nikolaus018/garageDoor-pro/hardware/production/render-bottom.png

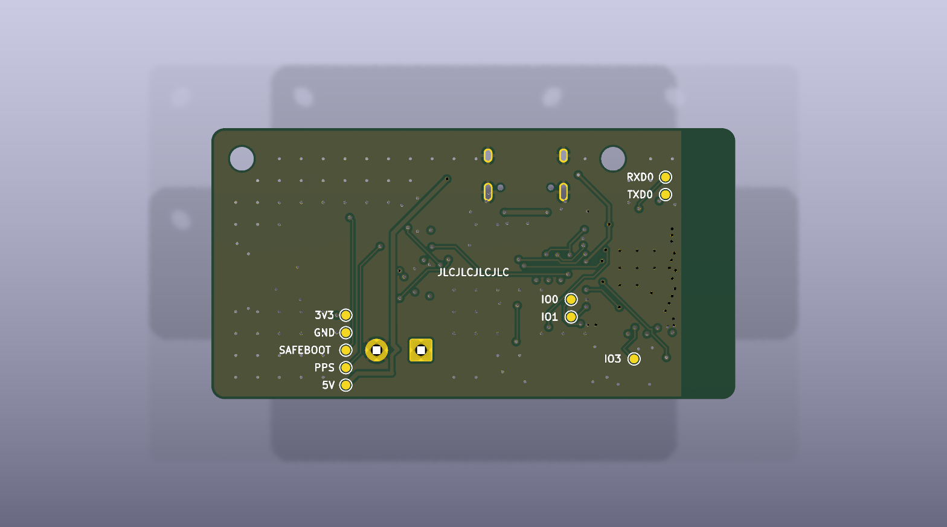
hardware/production/render-bottom.png
