nikolaus018/garageDoor-pro/hardware/production/render-top.png

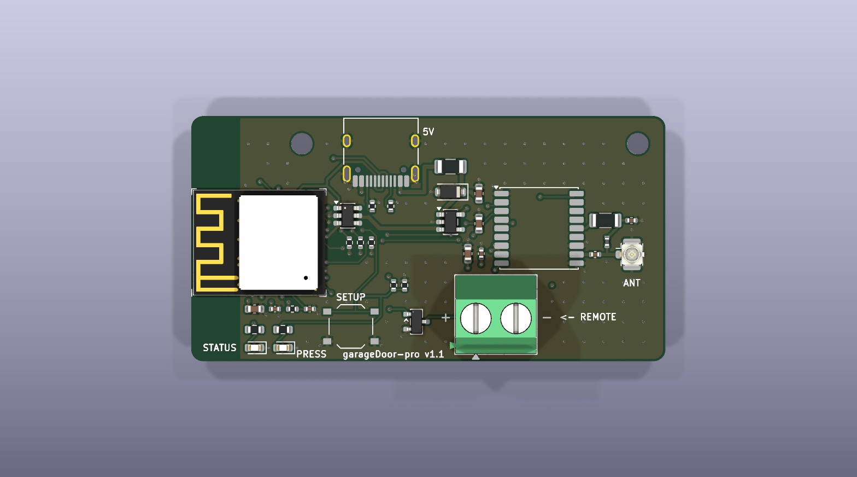
hardware/production/render-top.png
