nikolaus018/garageDoor-pro/hardware/production/bom-jlcpcb.csv

Comment | Designator | Footprint | LCSC Part # | Manufacturer Part | Quantity
10nF | C1 | C_0402_1005Metric | C15195 | CL05B103KB5NNNC | 1
47pF C0G | C2 | C_0402_1005Metric | C1567 | 0402CG470J500NT | 1
10uF | C3,C4,C5,C7 | C_0603_1608Metric | C19702 | CL10A106KP8NNNC | 4
100nF | C6,C8 | C_0402_1005Metric | C60474 | CC0402KRX7R7BB104 | 2
1uF | C9 | C_0402_1005Metric | C14445 | CL05A105KP5NNNC | 1
SMF5.0A | D1 | D_SOD-123F | C1509112 | SMF5.0A | 1
RED | D2 | LED_0603_1608Metric | C2286 | KT-0603R | 1
GREEN | D3 | LED_0603_1608Metric | C12624 | KT-0603G | 1
500mA | F1 | Fuse_1206_3216Metric | C22472478 | SMD1206-050C-6V | 1
USB-C | J1 | USB_C_Receptacle_HRO_TYPE-C-31-M-12 | C165948 | TYPE-C-31-M-12 | 1
U.FL GNSS antenna | J2 | U.FL_Hirose_U.FL-R-SMT-1_Vertical | C88373 | U.FL-R-SMT-1(10) | 1
Remote button | J3 | TerminalBlock_Phoenix_MKDS-1,5-2-5.08_1x02_P5.08mm_Horizontal | C474952 | KF128-5.08-2P | 1
27nH | L1 | L_0402_1005Metric | C12669 | LQG15HS27NJ02D | 1
SS8050 | Q1 | SOT-23 | C2150 | SS8050 | 1
10R | R1 | R_1206_3216Metric | C17903 | 1206W4F100JT5E | 1
10k | R2,R3,R4,R5 | R_0402_1005Metric | C25744 | 0402WGF1002TCE | 4
5.1k | R6,R7 | R_0402_1005Metric | C25905 | 0402WGF5101TCE | 2
330R | R8 | R_0402_1005Metric | C25104 | 0402WGF3300TCE | 1
100k | R9 | R_0402_1005Metric | C25741 | 0402WGF1003TCE | 1
1k | R10,R11 | R_0603_1608Metric | C21190 | 0603WAF1001T5E | 2
SETUP | SW1 | SW_Push_1P1T_XKB_TS-1187A | C318884 | TS-1187A-B-A-B | 1
ESP32-C3-MINI-1-H4X | U1 | ESP32-C3-MINI-1 | C41349510 | ESP32-C3-MINI-1-H4X | 1
MAX-M10S | U2 | ublox_MAX | C4153167 | MAX-M10S-00B | 1
AP2112K-3.3 | U3 | SOT-23-5 | C51118 | AP2112K-3.3TRG1 | 1
USBLC6-2SC6 | U4 | SOT-23-6 | C7519 | USBLC6-2SC6 | 1
