nikolaus018/garageDoor-pro/prototype/case/garageDoor-case.3mf

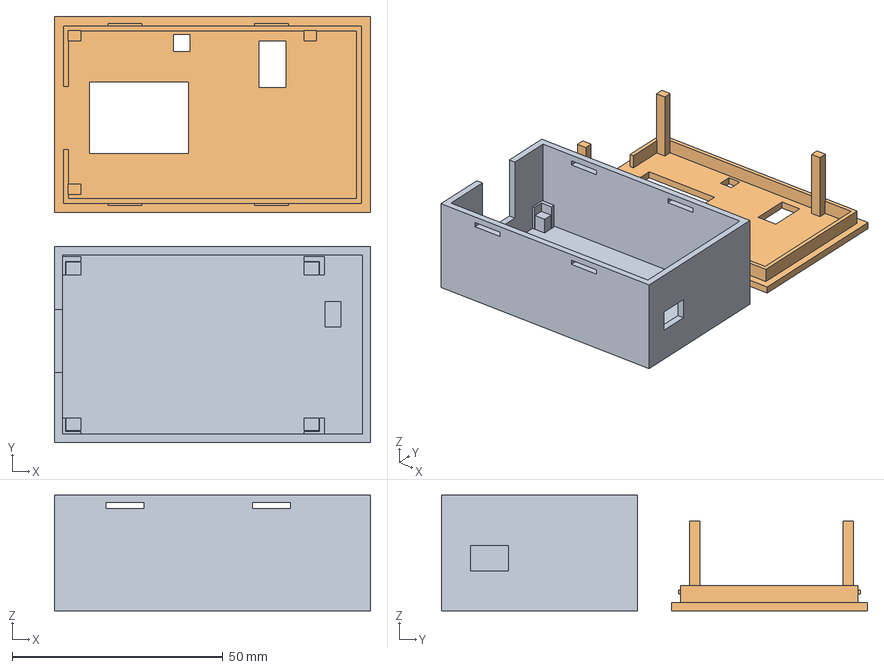
[picture p6: CAD file, 2026-10-16]
prototype/case/garageDoor-case.3mf
75.1 x 101.1 x 27.5 mm
tray
lid
