nikolaus018/garageDoor-pro/hardware/production/schematic.pdf

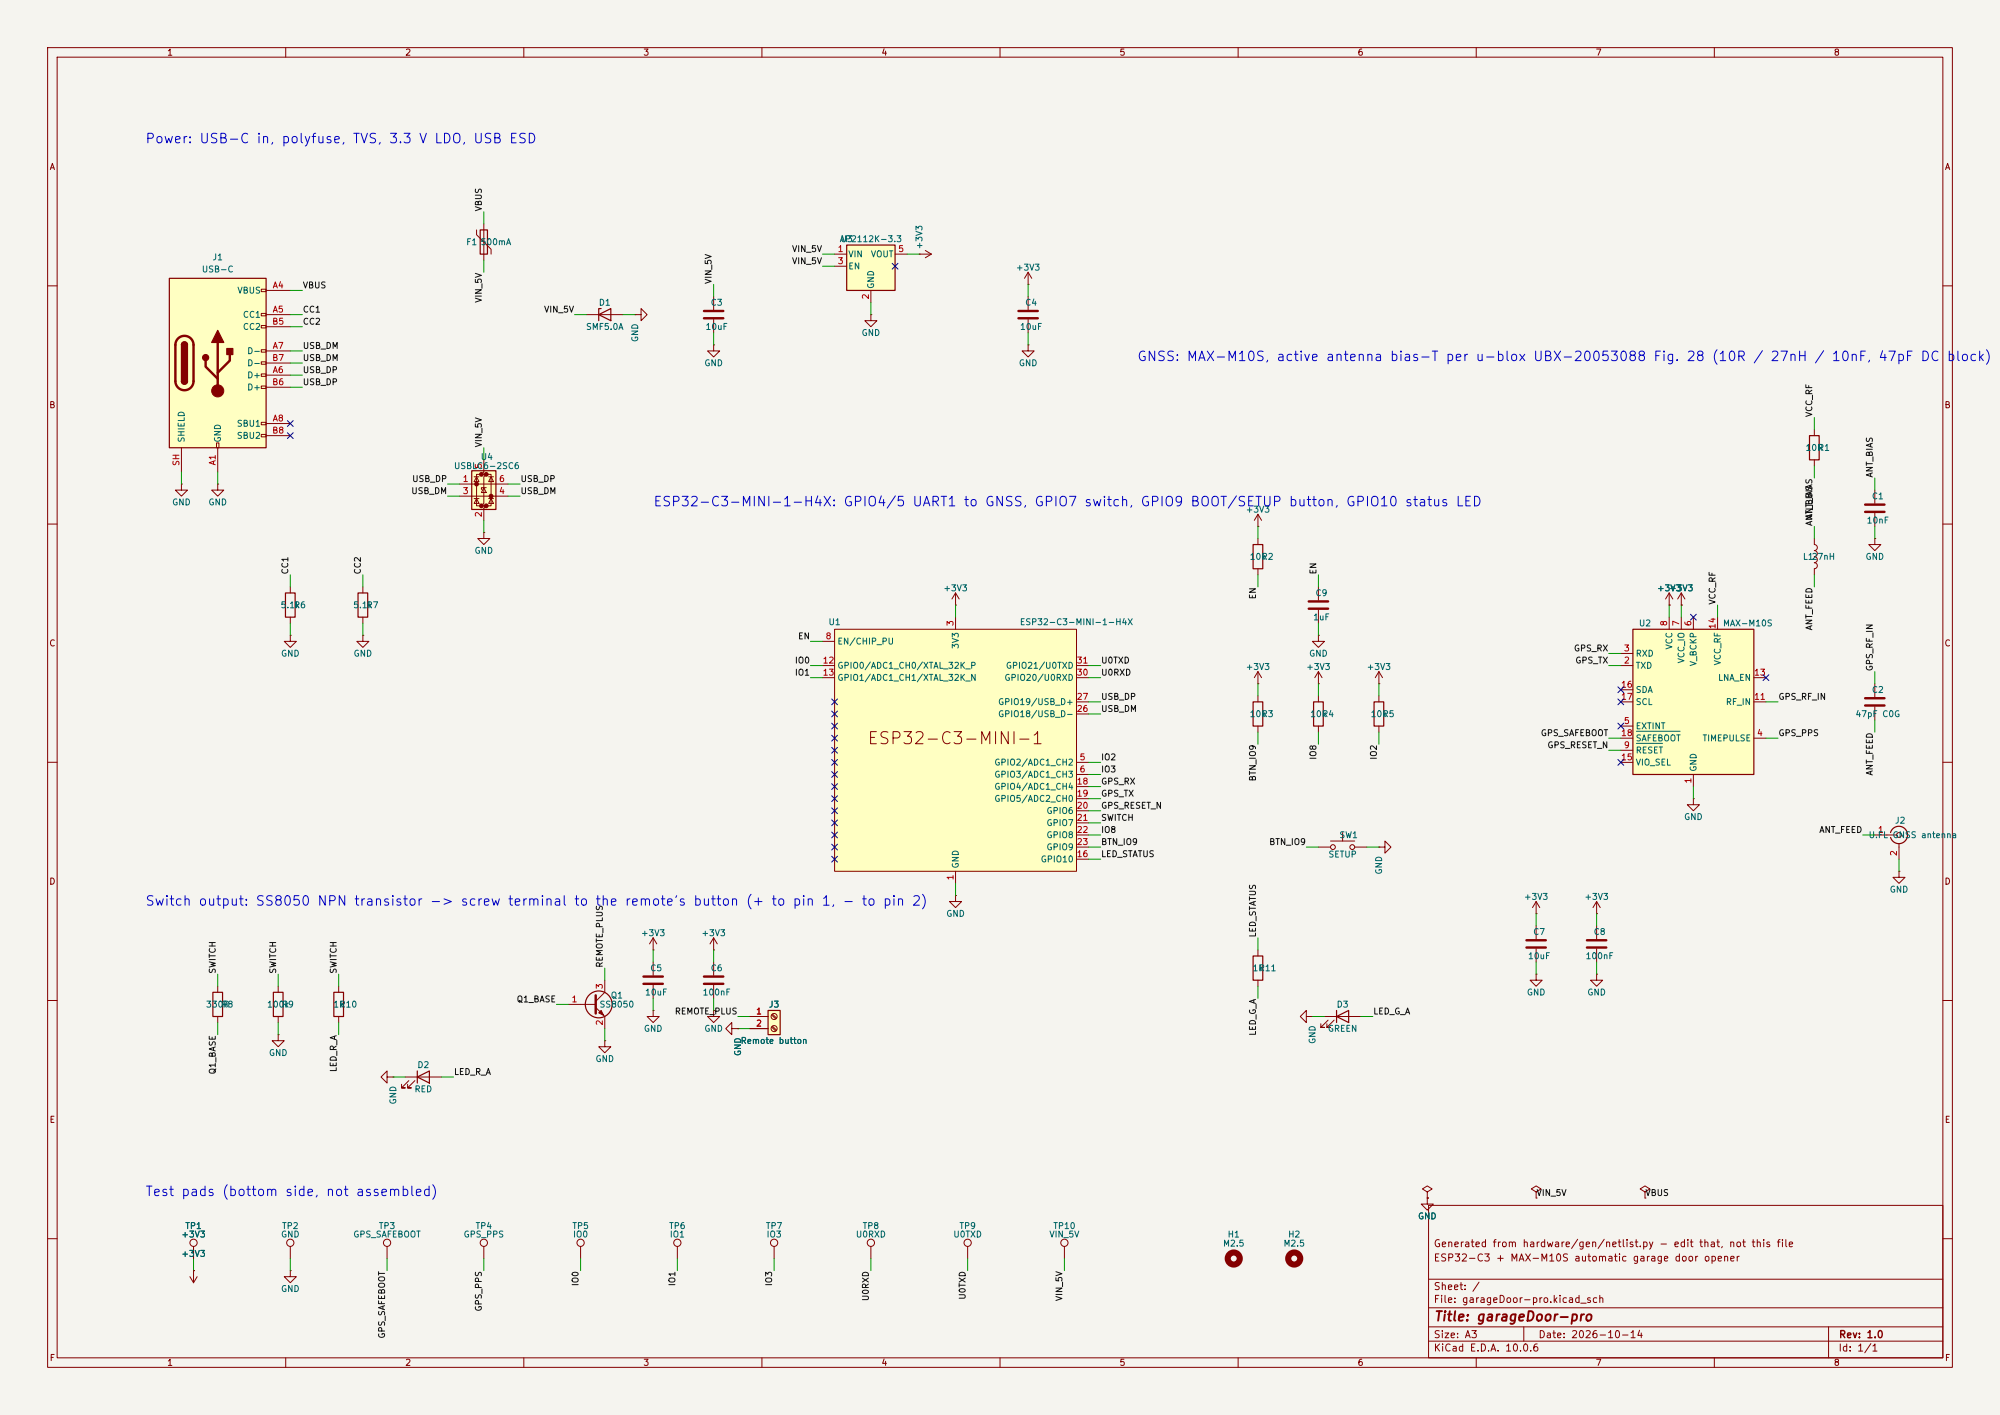
[picture p7: page 1]

IO1 Power: USB-C in, polyfuse, TVS, 3.3 V LDO, USB ESD

GNSS: MAX-M10S, active antenna bias-T per u-blox UBX-20053088 Fig. 28 (10R / 27nH / 10nF, 47pF DC block)

ESP32-C3-MINI-1-H4X: GPIO4/5 UART1 to GNSS, GPIO7 switch, GPIO9 BOOT/SETUP button, GPIO10 status LED

Generated from hardware/gen/netlist.py - edit that, not this file +3V3 GND

Test pads (bottom side, not assembled)

ESP32-C3 + MAX-M10S automatic garage door opener

Size: A3 | Rev: 1.0 | F Date: 2026-10-14
KiCad E.D.A. 10.0.6 | Id: 1/1
