nikolaus018/garageDoor-pro/hardware/production/assembly-top.pdf

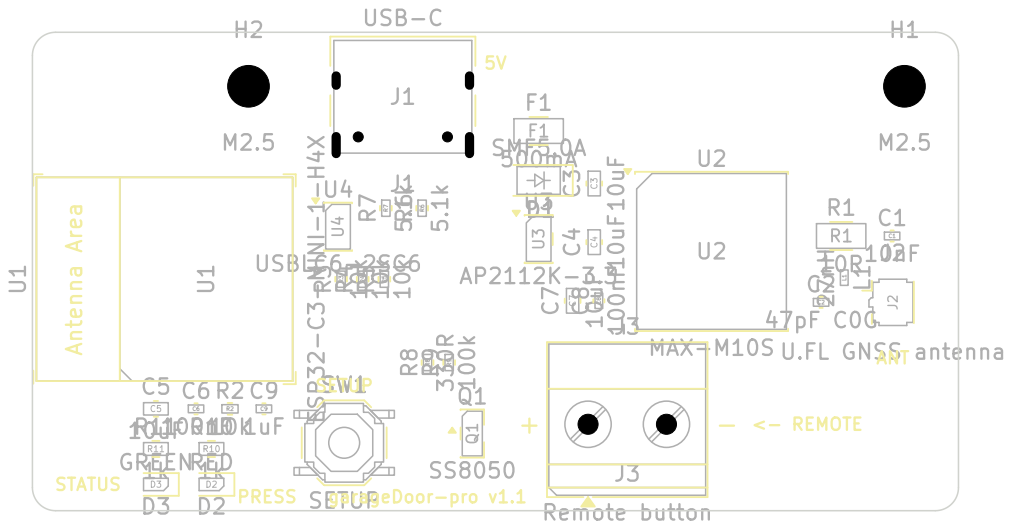
[picture p8: page 1]
