nikolaus018/garageDoor-pro/hardware/garageDoor-pro.kicad_pcb

## KiCad design hardware/garageDoor-pro.kicad_pcb (2026-10-15)

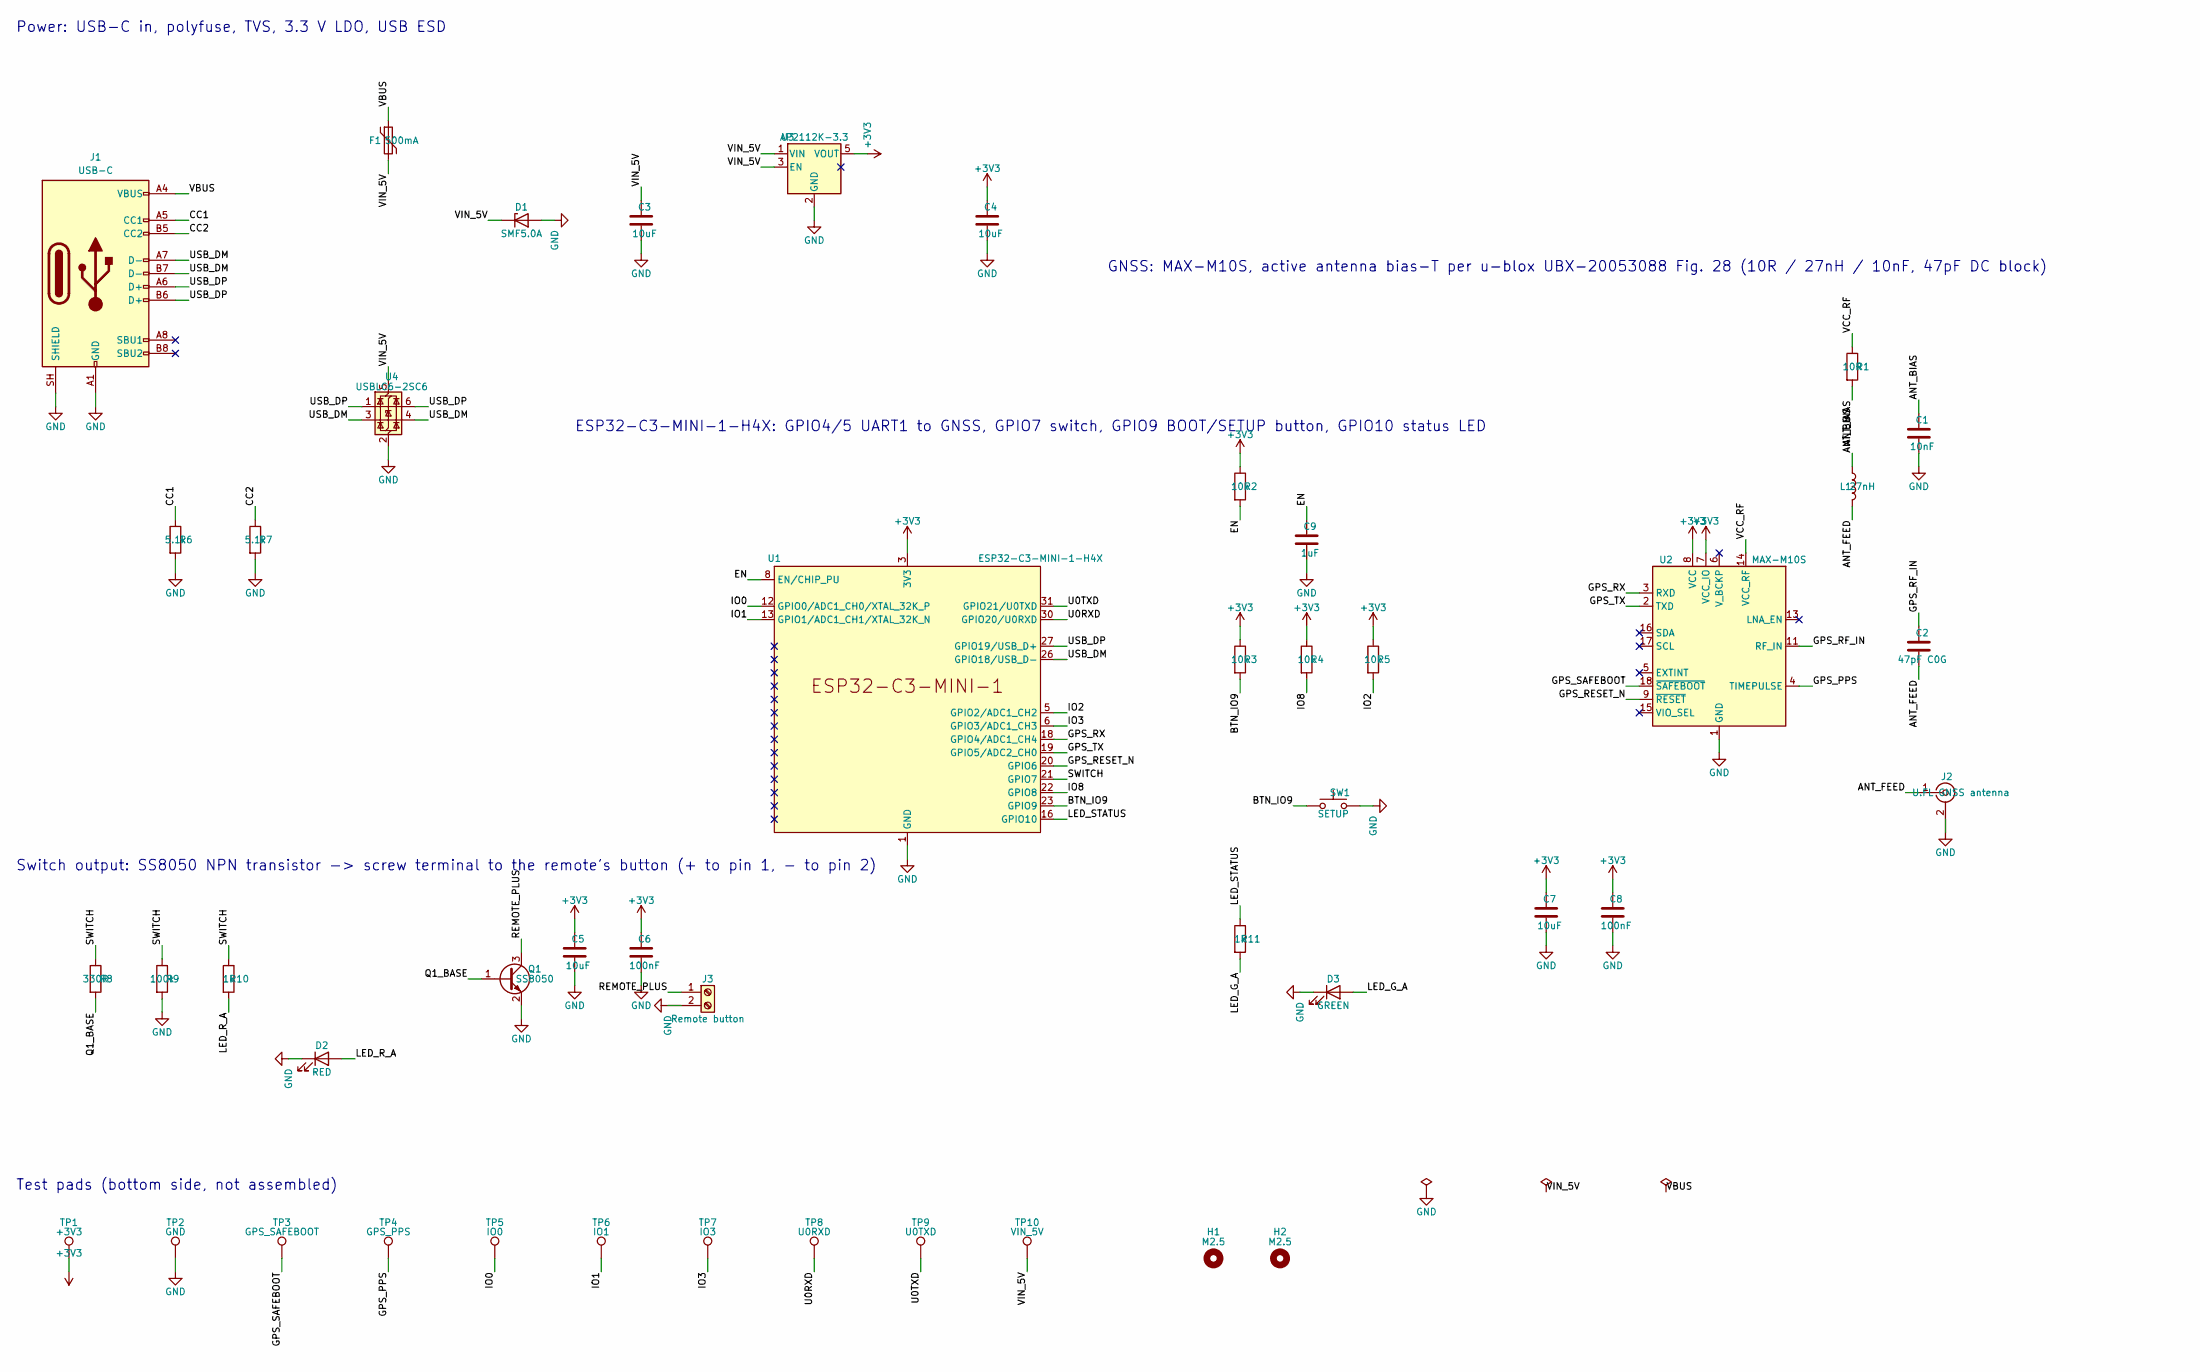
[picture p9: schematic garageDoor-pro.kicad_sch]

Parts:
C1: 10nF; C_0402_1005Metric; MPN CL05B103KB5NNNC; LCSC C15195
C2: 47pF C0G; C_0402_1005Metric; MPN 0402CG470J500NT; LCSC C1567
C3, C4, C5, C7: 10uF; C_0603_1608Metric; MPN CL10A106KP8NNNC; LCSC C19702
C6, C8: 100nF; C_0402_1005Metric; MPN CC0402KRX7R7BB104; LCSC C60474
C9: 1uF; C_0402_1005Metric; MPN CL05A105KP5NNNC; LCSC C14445
D1: SMF5.0A; D_SOD-123F; MPN SMF5.0A; LCSC C1509112
D2: RED; LED_0603_1608Metric; MPN KT-0603R; LCSC C2286
D3: GREEN; LED_0603_1608Metric; MPN KT-0603G; LCSC C12624
F1: 500mA; Fuse_1206_3216Metric; MPN SMD1206-050C-6V; LCSC C22472478
H1, H2: M2.5; MountingHole_2.7mm_M2.5
J1: USB-C; USB_C_Receptacle_HRO_TYPE-C-31-M-12; MPN TYPE-C-31-M-12; LCSC C165948
J2: U.FL GNSS antenna; U.FL_Hirose_U.FL-R-SMT-1_Vertical; MPN U.FL-R-SMT-1(10); LCSC C88373
J3: Remote button; TerminalBlock_Phoenix_MKDS-1,5-2-5.08_1x02_P5.08mm_Horizont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; MPN KF128-5.08-2P; LCSC C474952
L1: 27nH; L_0402_1005Metric; MPN LQG15HS27NJ02D; LCSC C12669
Q1: SS8050; SOT-23; MPN SS8050; LCSC C2150
R1: 10R; R_1206_3216Metric; MPN 1206W4F100JT5E; LCSC C17903
R2, R3, R4, R5: 10k; R_0402_1005Metric; MPN 0402WGF1002TCE; LCSC C25744
R6, R7: 5.1k; R_0402_1005Metric; MPN 0402WGF5101TCE; LCSC C25905
R8: 330R; R_0402_1005Metric; MPN 0402WGF3300TCE; LCSC C25104
R9: 100k; R_0402_1005Metric; MPN 0402WGF1003TCE; LCSC C25741
R10, R11: 1k; R_0603_1608Metric; MPN 0603WAF1001T5E; LCSC C21190
SW1: SETUP; SW_Push_1P1T_XKB_TS-1187A; MPN TS-1187A-B-A-B; LCSC C318884
TP1: +3V3; TestPoint_Pad_D1.0mm
TP2: GND; TestPoint_Pad_D1.0mm
TP3: GPS_SAFEBOOT; TestPoint_Pad_D1.0mm
TP4: GPS_PPS; TestPoint_Pad_D1.0mm
TP5: IO0; TestPoint_Pad_D1.0mm
TP6: IO1; TestPoint_Pad_D1.0mm
TP7: IO3; TestPoint_Pad_D1.0mm
TP8: U0RXD; TestPoint_Pad_D1.0mm
TP9: U0TXD; TestPoint_Pad_D1.0mm
TP10: VIN_5V; TestPoint_Pad_D1.0mm
U1: ESP32-C3-MINI-1-H4X; ESP32-C3-MINI-1; MPN ESP32-C3-MINI-1-H4X; LCSC C41349510
U2: MAX-M10S; ublox_MAX; MPN MAX-M10S-00B; LCSC C4153167
U3: AP2112K-3.3; SOT-23-5; MPN AP2112K-3.3TRG1; LCSC C51118
U4: USBLC6-2SC6; SOT-23-6; MPN USBLC6-2SC6; LCSC C7519

Connections:
+3V3: C4.1, C5.1, C6.1, C7.1, C8.1, R2.1, R3.1, R4.1, R5.1, TP1.1, U1.3 (3V3), U2.7 (VCC_IO), U2.8 (VCC), U3.5 (VOUT)
/ANT_BIAS: C1.1, L1.1, R1.2
/ANT_FEED: C2.2, J2.1 (In), L1.2
/BTN_IO9: R3.2, SW1.1, U1.23 (GPIO9)
/CC1: J1.A5 (CC1), R6.1
/CC2: J1.B5 (CC2), R7.1
/EN: C9.1, R2.2, U1.8 (EN/CHIP_PU)
/GPS_PPS: TP4.1, U2.4 (TIMEPULSE)
/GPS_RESET_N: U1.20 (GPIO6), U2.9 (~RESET)
/GPS_RF_IN: C2.1, U2.11 (RF_IN)
/GPS_RX: U1.18 (GPIO4/ADC1_CH4), U2.3 (RXD)
/GPS_SAFEBOOT: TP3.1, U2.18 (~SAFEBOOT)
/GPS_TX: U1.19 (GPIO5/ADC2_CH0), U2.2 (TXD)
/IO0: TP5.1, U1.12 (GPIO0/ADC1_CH0/XTAL_32K_P)
/IO1: TP6.1, U1.13 (GPIO1/ADC1_CH1/XTAL_32K_N)
/IO2: R5.2, U1.5 (GPIO2/ADC1_CH2)
/IO3: TP7.1, U1.6 (GPIO3/ADC1_CH3)
/IO8: R4.2, U1.22 (GPIO8)
/LED_G_A: D3.2 (A), R11.2
/LED_R_A: D2.2 (A), R10.2
/LED_STATUS: R11.1, U1.16 (GPIO10)
/Q1_BASE: Q1.1 (B), R8.2
/REMOTE_PLUS: J3.1, Q1.3 (C)
/SWITCH: R8.1, R9.1, R10.1, U1.21 (GPIO7)
/U0RXD: TP8.1, U1.30 (GPIO20/U0RXD)
/U0TXD: TP9.1, U1.31 (GPIO21/U0TXD)
/USB_DM: J1.A7 (D-), J1.B7 (D-), U1.26 (GPIO18/USB_D-), U4.3 (I/O2), U4.4 (I/O2)
/USB_DP: J1.A6 (D+), J1.B6 (D+), U1.27 (GPIO19/USB_D+), U4.1 (I/O1), U4.6 (I/O1)
/VBUS: F1.1, J1.A4 (VBUS), J1.A9 (VBUS), J1.B4 (VBUS), J1.B9 (VBUS)
/VCC_RF: R1.1, U2.14 (VCC_RF)
/VIN_5V: C3.1, D1.1 (K), F1.2, TP10.1, U3.1 (VIN), U3.3 (EN), U4.5 (VBUS)
GND: C1.2, C3.2, C4.2, C5.2, C6.2, C7.2, C8.2, C9.2, D1.2 (A), D2.1 (K), D3.1 (K), J1.A1 (GND), J1.A12 (GND), J1.B1 (GND), J1.B12 (GND), J1.SH (SHIELD), J2.2 (Ext), J3.2, Q1.2 (E), R6.2, R7.2, R9.2, SW1.2, TP2.1, U1.1 (GND), U1.2 (GND), U1.11 (GND), U1.14 (GND), U1.36 (GND), U1.37 (GND), U1.38 (GND), U1.39 (GND), U1.40 (GND), U1.41 (GND), U1.42 (GND), U1.43 (GND), U1.44 (GND), U1.45 (GND), U1.46 (GND), U1.47 (GND), U1.48 (GND), U1.49 (GND), U1.50 (GND), U1.51 (GND), U1.52 (GND), U1.53 (GND), U2.1 (GND), U2.10 (GND), U2.12 (GND), U3.2 (GND), U4.2 (GND)

Notes on the sheet:
Power: USB-C in, polyfuse, TVS, 3.3 V LDO, USB ESD
ESP32-C3-MINI-1-H4X: GPIO4/5 UART1 to GNSS, GPIO7 switch, GPIO9 BOOT/SETUP button, GPIO10 status LED
GNSS: MAX-M10S, active antenna bias-T per u-blox UBX-20053088 Fig. 28 (10R / 27nH / 10nF, 47pF DC block)
Switch output: SS8050 NPN transistor -> screw terminal to the remote's button (+ to pin 1, - to pin 2)
Test pads (bottom side, not assembled)

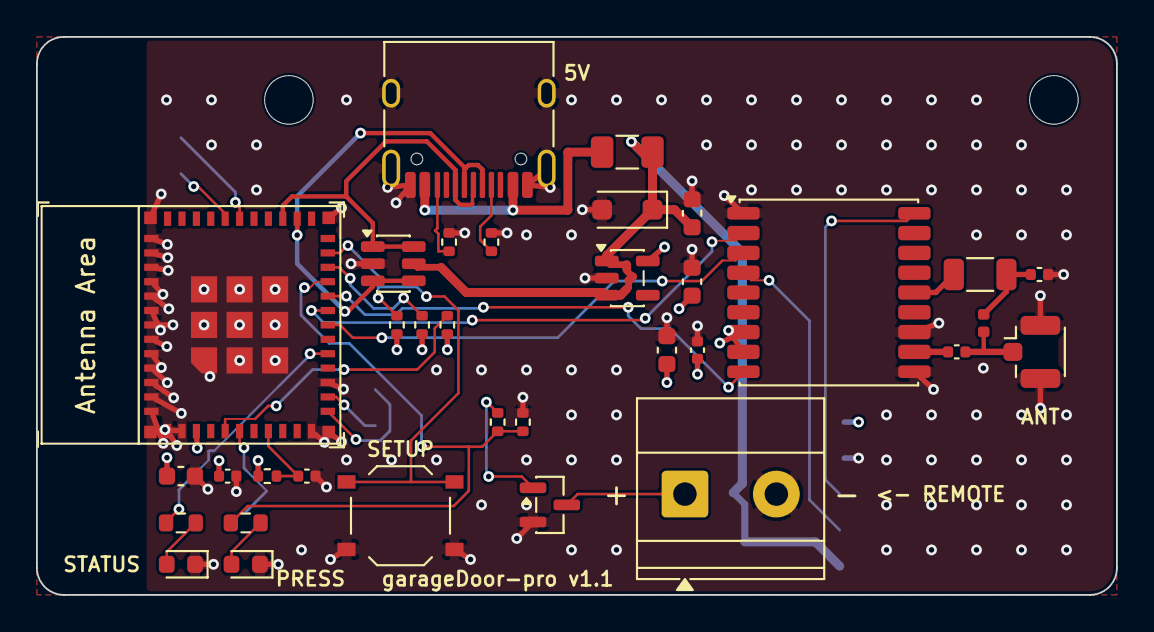
[picture p10: board garageDoor-pro.kicad_pcb from above]

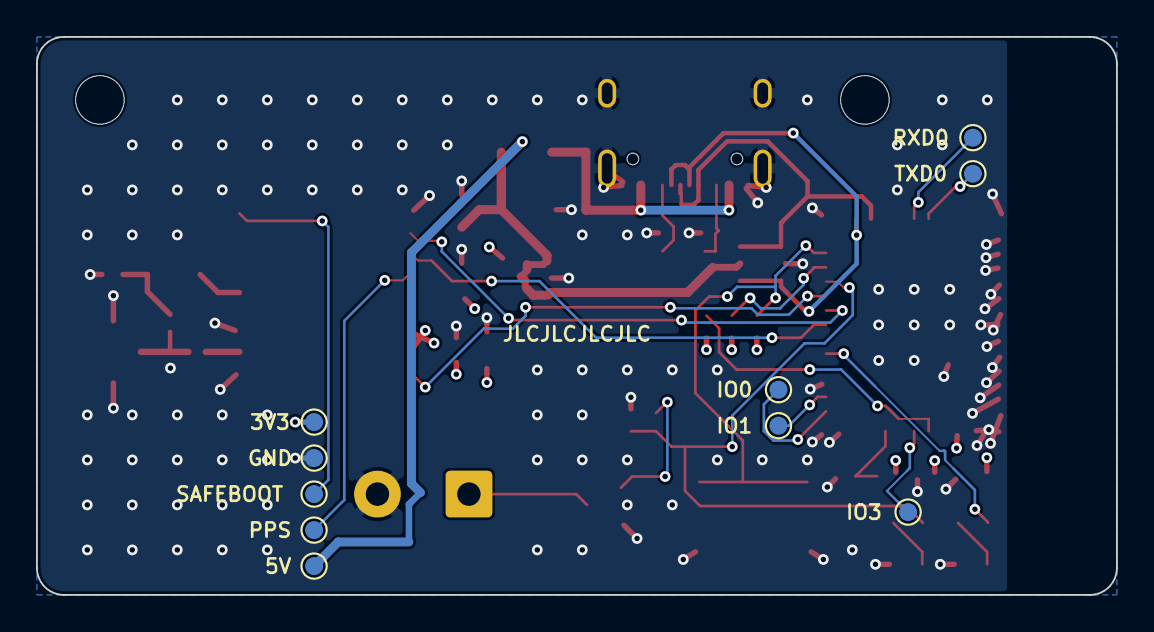
[picture p11: board garageDoor-pro.kicad_pcb from below]

Board: 4 copper layers, 60.0 x 31.0 mm, 46 parts (10 on the bottom side), 32 nets.
