nikolaus018/garageDoor-pro/(commit log)

2026-10-14 Design spec for the all-in-one garage door board
    ESP32-C3-MINI-1-H4X + MAX-M10S GPS + AQY212GS PhotoMOS + screw terminal,
    USB-C powered, web panel to set home. Parts verified live on LCSC; GPS
    power/antenna circuit taken from the u-blox integration manual R05.
2026-10-14 Hardware: netlist-driven schematic (ERC clean) and placed 4-layer PCB
    Schematic and PCB are generated from hardware/gen/netlist.py; ERC has 0
    errors/warnings and DRC reports 0 schematic-parity issues. Part changes
    vs. the design doc: CPC1017N PhotoMOS (exact KiCad footprint), Espressif's
    official ESP32-C3-MINI-1 footprint/symbol, 0603/0402 basic passives with
    verified LCSC stock.
2026-10-14 Hardware: routed, DRC-clean board and JLCPCB order package
    - GND/3V3 fanout into solid inner planes, hand-routed 50 ohm GNSS RF path
    and USB VBUS, Freerouting for the remaining signals (inner layers kept as
    planes), outer GND pours and stitching vias
    - DRC: 0 violations, 0 unconnected, 0 schematic-parity issues; ERC clean
    - production/: Gerbers + Excellon (zip), JLCPCB BOM and CPL, schematic and
    assembly PDFs, 3D renders, STEP
    - build.sh regenerates everything from gen/netlist.py
2026-10-14 Firmware, docs and final hardware package
    firmware/ (ESP-IDF v6.1, ESP32-C3):
    - MAX-M10S over UBX (NAV-PVT 1 Hz, 115200, automotive), reconfigure/reset
    watchdog; trip state machine with home/away memory, arrive/leave
    hysteresis and drive-by detection; PhotoMOS presser; LED codes; SETUP
    button (3 s setup Wi-Fi, 10 s factory reset)
    - WPA2 setup AP with captive portal and web panel (set home from GPS or
    coordinates, settings, test press, password, OTA with rollback); the
    panel is locked until the default password is changed
    - host unit tests (UBX, geo, trip) under ASan/UBSan; mock panel server
    - builds with -Wall -Wextra -Werror, 56 % of the OTA slot free
    docs: design.md updated to t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
2026-10-14 Self-assembly path: JLCPCB stencil + LCSC parts list
    ORDERING.md gets a bare-PCB + 0.12 mm steel stencil route with soldering
    steps; make_outputs.py also writes production/bom-lcsc.csv (parts for 3
    boards) for LCSC's BOM tool.
2026-10-14 Perfboard prototype: build guide, verified layout, firmware for module boards
    prototype/: parts list, hole-by-hole layout (top + mirrored bottom view,
    generated by make_layout.py, which also verifies the trails/wires against
    the intended circuit), bridge-vs-trail-vs-wire rules, assembly steps,
    pre-power measurements, bench test and install notes. Built from an
    ESP32-C3 SuperMini, a UART GPS module, an AQY212EH PhotoMOS and a screw
    terminal.
    firmware:
    - board choice in menuconfig: C3 SuperMini (default), S3 DevKitC, PCB v1
    - LED polarity per board (SuperMini LED is active-low on GPIO8)
    - GPS: baud-rate search (115200/9600/38400/57600/230400) and NMEA GGA
    fallback, so any UART GPS module wo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
2026-10-14 Fix PCB image display and clean up README
    Updated PCB image display and removed legacy reference.
2026-10-14 Finish prototype build pictures and review fixes
    - make_layout.py: CSS classes overrode font-size/text-anchor on labels
    (USB-C label overflow, GPS caption over the wires); inline them.
    Vertical trail labels go below the trail so T5/T6 no longer overlap;
    no duplicate header labels once the SuperMini is drawn.
    - prototype/README.md: fix moved layout image link, add wiring diagram
    and step pictures, solder the GPS header with the other headers (as
    the pictures show), extend the short check to L2-L5, warn about SMD
    PhotoMOS variants and stock, drop ambiguous KF128 terminal.
    - geo.c: M_PI is not standard C, host tests failed to build on Linux.
    - Stale docs/prototype-build.md reference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
2026-10-14 Prototype: power the GPS from 3V3 for 3.3 V modules (ATGM336H)
    The ATGM336H runs on 2.7-3.6 V; the old layout fed GPS VCC from 5V.
    GPS header is now TX/GND/VCC/RX at L2-L5 so VCC sits under the 3V3 pin:
    T5 J4-K4-L4, W1 L2 -> D2. Verified net list, pictures, parts list,
    measurement table and GPS hookup step updated. Firmware unchanged
    (it finds the 9600 baud NMEA receiver itself).
    Claude-Session: https://claude.ai/code/session_01L6nmkoDpAiNRemYGzDNqGt
2026-10-14 Prototype: PC817C optocoupler as K1 instead of the AQY212EH PhotoMOS
    The AQY212EH is out of stock at LCSC, Conrad and Amazon; the PC817C is
    the same DIP-4 footprint and pinout (1 anode, 2 cathode, 3 emitter,
    4 collector), so the layout, R1/R2 and firmware stay as they are.
    Its output is a transistor: the guide now says which side of the
    remote's button goes to which screw and how to find it, and keeps the
    PhotoMOS parts as the any-polarity drop-in. The PCB keeps its CPC1017N.
    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
2026-10-14 Prototype guide: show the step-by-step images, fix layout image path
    Host tests: build with gnu11 so M_PI is defined on Linux too.
    Claude-Session: https://claude.ai/code/session_019oPMWHkvD8ZvWUy7CwCP4Q
2026-10-15 Prototype layout: match the SuperMini mounted chip side up
    The perfboard layout had the SuperMini's two pin rows swapped, as if the
    module were seen from below. Plugged in chip side up, W1 would have put
    5 V on the GPS TX pin and R1 would have sat on 3V3, keeping the remote
    pressed. The 5V..0 row now goes in D2-D9 with the GPS header above it
    (B2-B5), and the optocoupler block moved next to GPIO7 in rows K-M.
    README hole references, the measuring table and all pictures follow.
2026-10-15 User guide: restart setup from step 2 after a factory reset
    A reset also erases the Wi-Fi password and the home position, so the
    board reopens the setup Wi-Fi by itself and you join it with the default
    password again (step 2), not step 3.
2026-10-15 Prototype layout: use the printed hole names of the 50*70MM perfboard
    The common green 50 x 70 mm perfboard has letters A-R (A at the bottom)
    and numbers 1-24 printed on one side. The layout now uses exactly those
    names: parts go on the printed side, the pictures draw the whole
    24 x 18 board with its print, edge pads and mounting holes, and the
    circuit moved to rows B-M so nothing covers the printed numbers. The
    circuit itself is unchanged.
2026-10-15 Review fixes: NaN coordinates, bench test, USB-C power note
    - Web panel: reject "nan" as a home coordinate (strtod accepts it and
    the range check let it through).
    - Bench test: a continuity beep across the optocoupler is not reliable
    (~100 ohm when switched), so no beep is fine; the remote's own LED and
    the door are the real test.
    - Parts list: some SuperMini clones lack the USB-C CC resistors and get
    no power from C-to-C cables; use a USB-A charger with an A-to-C cable.
    - Drop a stale reference to the old beacon.
2026-10-15 Setup Wi-Fi: open, no password
    The board lives in the owner's car and the setup Wi-Fi only runs during
    setup (first start, or SETUP held 3 s) and switches off after 10 minutes
    without use, so the password just got in the way.
    - Soft AP uses WIFI_AUTH_OPEN; the password endpoint, the panel lock and
    the restart-on-password-change timer are gone.
    - settings_t drops ap_password/password_changed (SETTINGS_VERSION 2, so
    old stored settings fall back to defaults).
    - Panel, mock server and all docs follow; design.md notes that anyone in
    range during setup can use the whole panel.
2026-10-15 Prototype pictures: bare solder side, joints labelled
    The perfboard's letters and numbers are printed on the parts side only,
    so the solder-side views no longer show (faded) hole names. Instead they
    show dashed outlines of the parts on the other side and label every
    joint (SuperMini pin names, GPS pins, K1 pins, J1 screws). Trails and
    wires are described by the joints they connect, with the printed hole
    names in brackets in the README. Adds notes for soldering the SuperMini
    in directly when the female headers are missing.
2026-10-15 Prototype: 40x60 mm board, red LED on GPIO7, trail instead of W3
    - Layout moved to the 40*60MM perfboard (20 x 14 holes, A-N, 1-20).
    - K1 pin 4 now reaches screw 1 through a bridge and a trail along row D (T8)
    instead of wire W3, so nothing on the output side lands next to pin 1.
    - Red LED D1 + R3 1k on GPIO7 shows every press, like the PCB's red LED.
    - Measurements check that the terminal side touches nothing but K1 pins 3/4;
    bench test checks the remote on its own first, then through the board.
    - Print-direction check: on a board with A at the top the layout would come
    out mirrored.
2026-10-15 Firmware 1.1.0: 400 ms presses, 5 s hold test, lower setup Wi-Fi power
    - Presses last 400 ms instead of 150 ms, like a person's press: fixed-code
    remotes repeat a ~50 ms frame while held and receivers want several.
    - Panel button "Hold the remote for 5 s" (POST /api/hold) closes the switch
    for 5 s so the wiring can be checked with a multimeter; any new command
    ends it early. Status JSON reports "holding". Mock panel supports it.
    - The setup access point transmits at 8.5 dBm, which cuts current peaks on
    the SuperMini's small regulator; the phone is always next to the board.
    - Docs: bench tests use the hold, ORDERING no longer says 150 ms.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
2026-10-15 NPN transistor switch everywhere; PCB v1.1 regenerated
    The perfboard proved it: the remote's button switches the whole remote
    on, and only a transistor driven from GPIO7 carries that current.
    - Prototype: Q1 NPN (TO-92: 2N2222, S8050, BC547, ...) in B12/C12/D12,
    straight trails for base, GND/emitter and collector, new pictures,
    leg-order table, measurements and bench test for the transistor.
    - PCB: SS8050 (SOT-23, LCSC C2150) replaces the CPC1017N; J3 pin 2 is
    GND, silkscreen marks + / - and says v1.1. Schematic, PCB, routing,
    Gerbers, BOM, CPL, PDFs, renders and STEP regenerated; ERC and DRC clean.
    route.py drops router vias left with copper on one layer only.
    - Docs and firmware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
2026-10-16 Prototype: GY-GPS6MV2 soldered on a header at I12-L12; 3D-printed case
    - The GPS module sits on a 1x4 male header in column 12 (VCC I12, RX J12,
    TX K12, GND L12), chip side up, its board toward the right edge, with the
    antenna stuck on top. No more Dupont jumpers.
    - Underneath: T5 (K3-L3-M3) gives two GND pads; wires W3/W4/W5 bring RX, 3V3
    and GND to the header, W1 now runs from K12. Old T5/T7 removed, T8/T9
    renumbered to T6/T7. Measurements and pictures updated.
    - prototype/case/make_case.py (stdlib only) builds garageDoor-case.3mf: tray
    with corner seats, USB-C notch and a window for the remote's wires; lid
    with a SuperMini window, LED hole, snap skirt and hold-down posts. It c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
2026-10-16 Prototype: GPS module plugs into a socket; round machined-pin sockets
    - SuperMini and GPS module both plug into round machined-pin (stackable)
    female headers: 2 x 1x8 in rows E/K, 1 x 1x4 at I12-L12. The modules get
    round male pins; square pins don't belong in round sockets.
    - Assembly: the GPS socket is soldered with the module plugged in, like the
    SuperMini's; step 7 now just plugs the module in. Pictures show round
    contacts.
    - Case: SOCKET_H (3 mm as drawn) sets the module height, and the case height
    follows it (8.5 mm square-hole headers give a 35 mm tall case). A pillar
    in the tray holds up the GPS module's free end.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
2026-10-16 Case: slot over J1's screws; room for the GPS antenna cable
    - The lid has a slot over both J1 screws, so the remote's wires can be
    tightened with the lid on; the script checks a screwdriver reaches them.
    - The case keeps room free for the patch antenna's cable: over the GPS
    module's far end to its socket, and in the corner beside J1 for the spare
    length. Both are checked against the case and the parts.
    - README: where the cable goes; lid description.
